hmichae2/combined-tirf-confocal-microscope/README.md

# combined-tirf-confocal-microscope

In this repository we show you how to build a setup for combined tirf and confocal microscopy. 

Here you see the page: https://hmichae2.github.io/combined-tirf-confocal-microscope/
