hmichae2/combined-tirf-confocal-microscope/images/slideshow/collimator.PNG

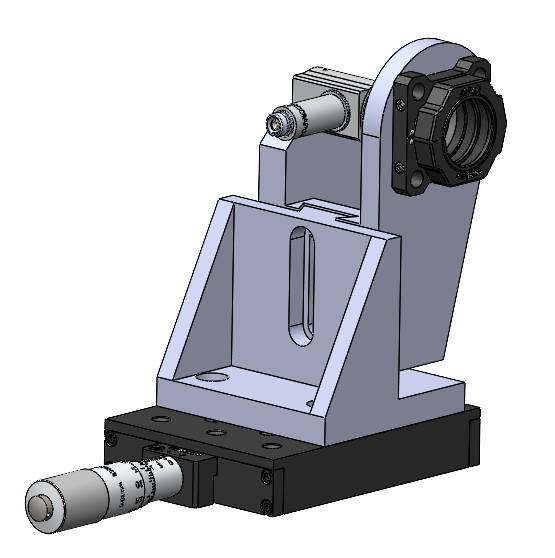
images/slideshow/collimator.PNG
