hmichae2/combined-tirf-confocal-microscope/images/slideshow/cube.PNG

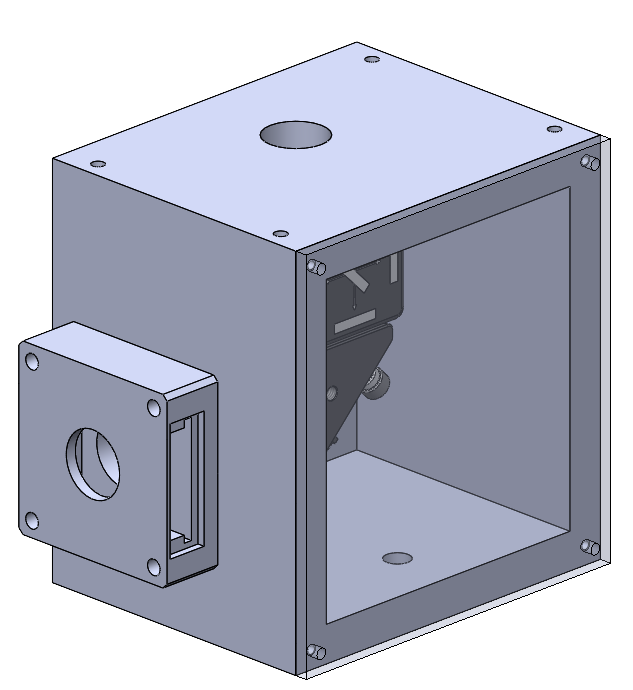
images/slideshow/cube.PNG
