hmichae2/combined-tirf-confocal-microscope/images/slideshow/sampleholder.PNG

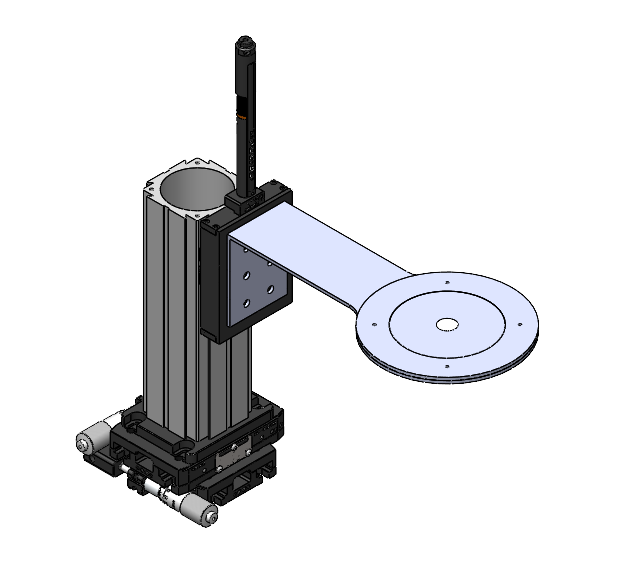
images/slideshow/sampleholder.PNG
