hmichae2/combined-tirf-confocal-microscope/images/components/camera_mount.PNG

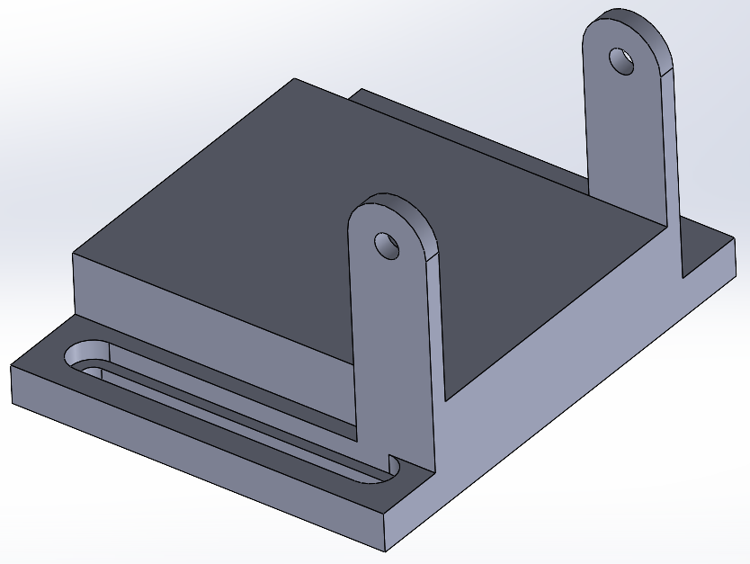
images/components/camera_mount.PNG
