hmichae2/combined-tirf-confocal-microscope/images/components/collimator_mount.PNG

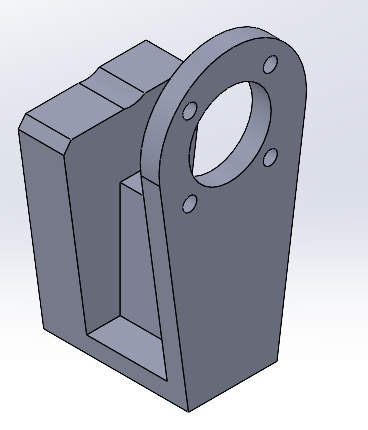
images/components/collimator_mount.PNG
