hmichae2/combined-tirf-confocal-microscope/images/components/collimator_mount_base.PNG

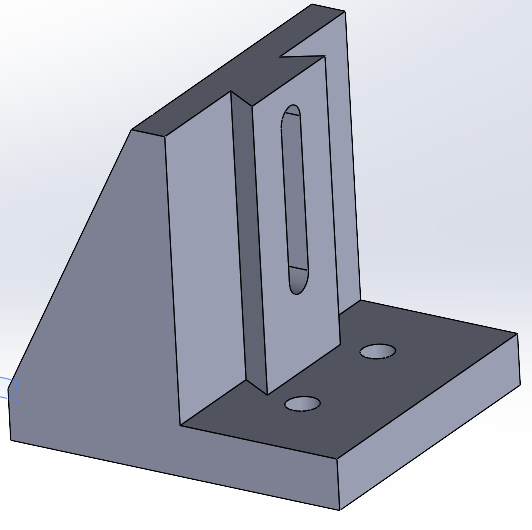
images/components/collimator_mount_base.PNG
