hmichae2/combined-tirf-confocal-microscope/images/components/cube.PNG

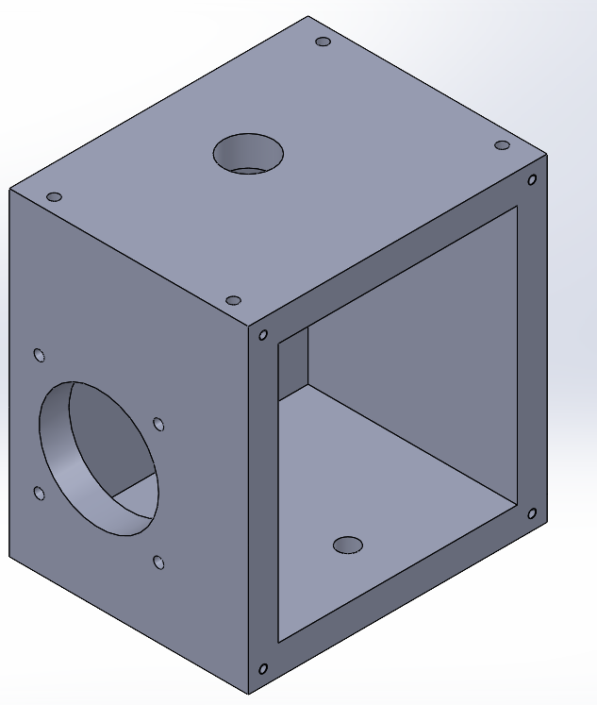
images/components/cube.PNG
