hmichae2/combined-tirf-confocal-microscope/images/components/laser_base_plate.PNG

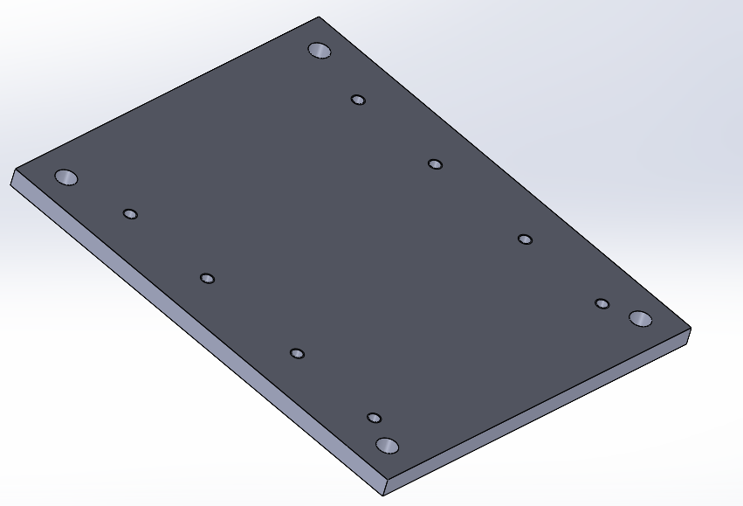
images/components/laser_base_plate.PNG
