hmichae2/combined-tirf-confocal-microscope/images/components/sample_holder.PNG

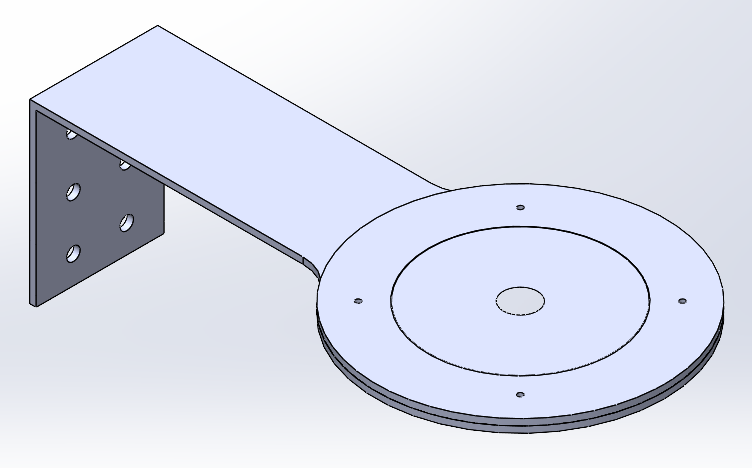
images/components/sample_holder.PNG
