hmichae2/combined-tirf-confocal-microscope/images/components/tube_lens_holder.PNG

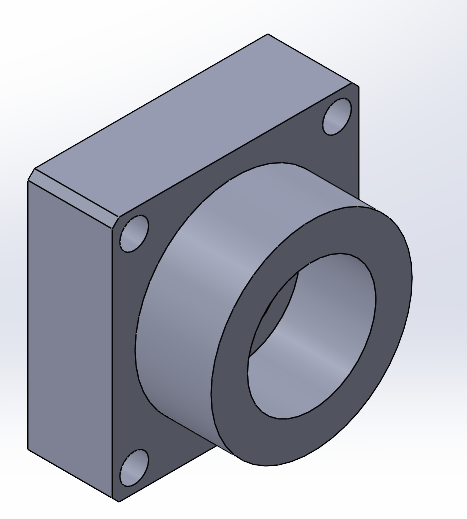
images/components/tube_lens_holder.PNG
