hmichae2/combined-tirf-confocal-microscope/components/cube door.STL

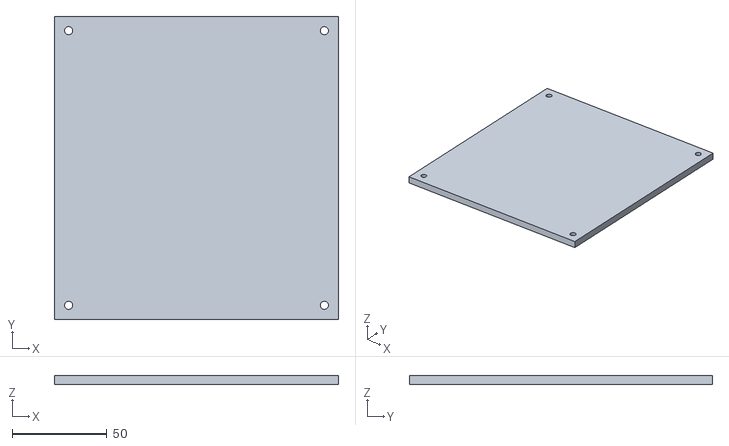
[picture p14: CAD file, 2021-05-02]
components/cube door.STL
150.0 x 160.0 x 5.00
