hmichae2/combined-tirf-confocal-microscope/components/sampleholder/sampleholder inlay.STL

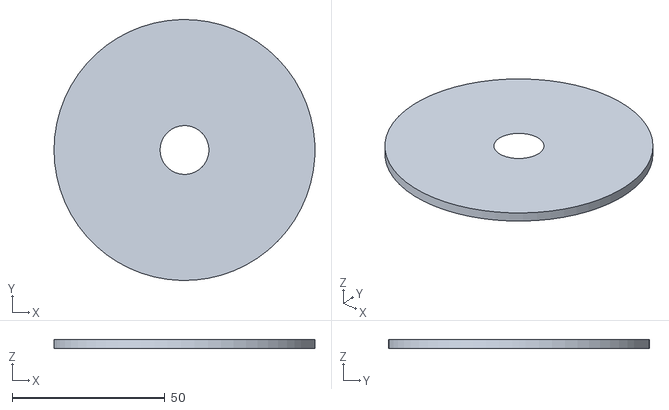
[picture p15: CAD file, 2021-05-02]
components/sampleholder/sampleholder inlay.STL
85.5 x 85.5 x 3.00
