hmichae2/combined-tirf-confocal-microscope/components/cube.STL

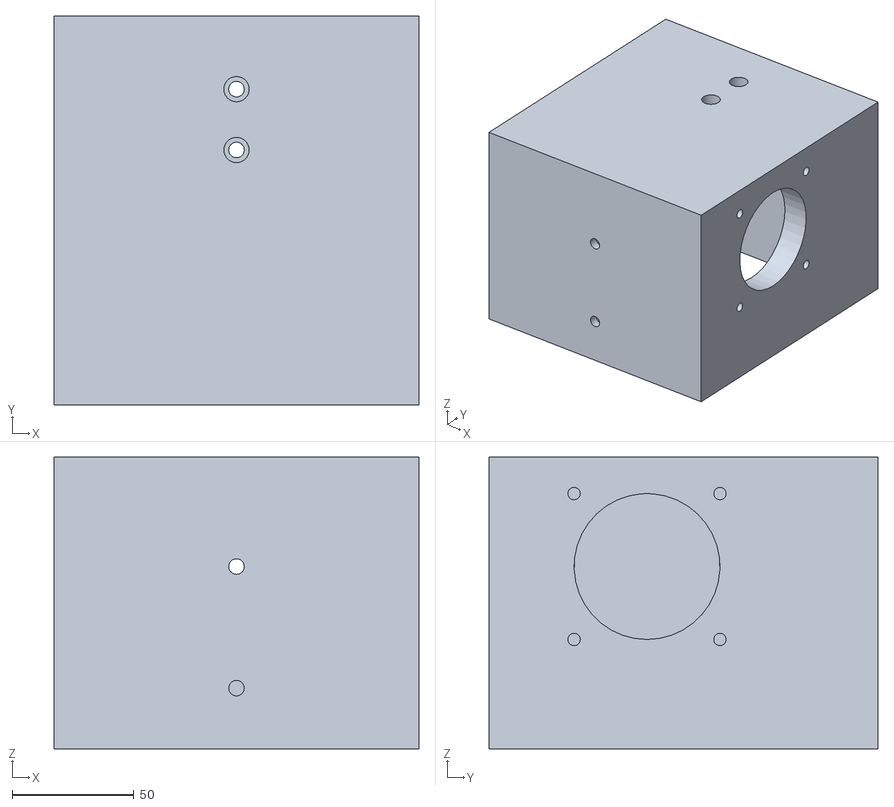
[picture p16: CAD file, 2021-05-02]
components/cube.STL
150.0 x 160.0 x 120.0
