hmichae2/combined-tirf-confocal-microscope/components/sampleholder/sampleholder.STL

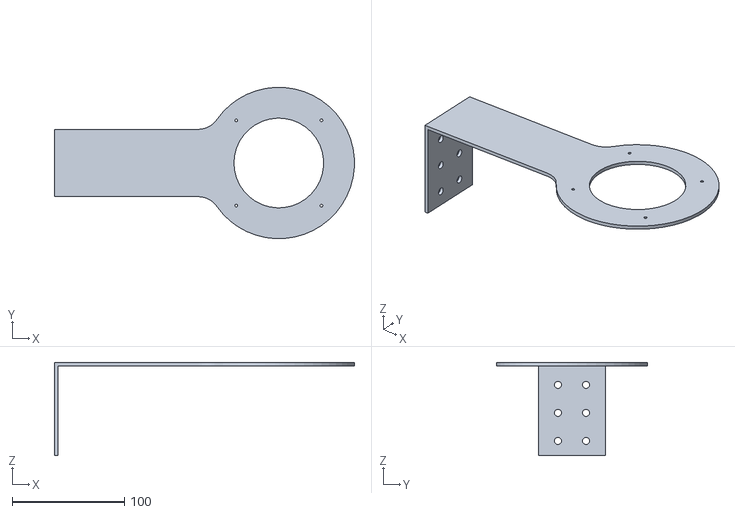
[picture p17: CAD file, 2021-05-02]
components/sampleholder/sampleholder.STL
267.5 x 135.0 x 83.0
