hmichae2/combined-tirf-confocal-microscope/components/sampleholder/sampleholder top.STL

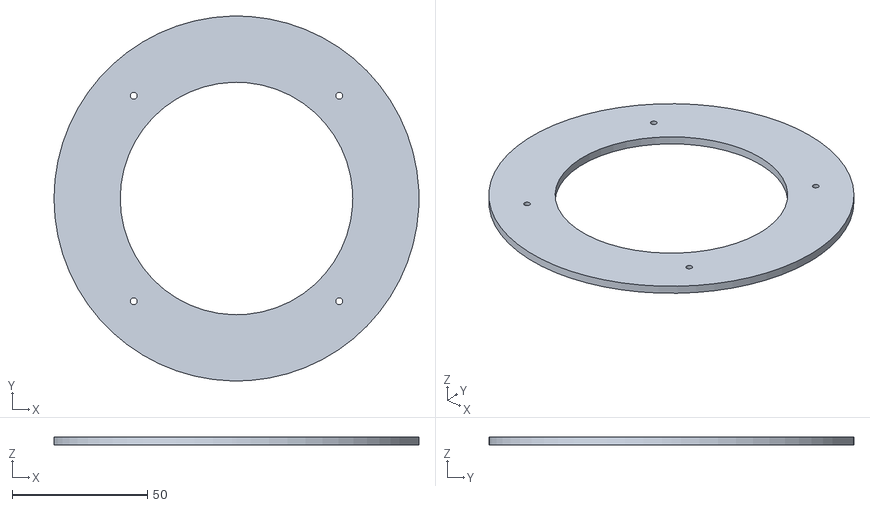
[picture p18: CAD file, 2021-05-02]
components/sampleholder/sampleholder top.STL
135.0 x 135.0 x 3.00
