hmichae2/combined-tirf-confocal-microscope/components/tube lens holder.STL

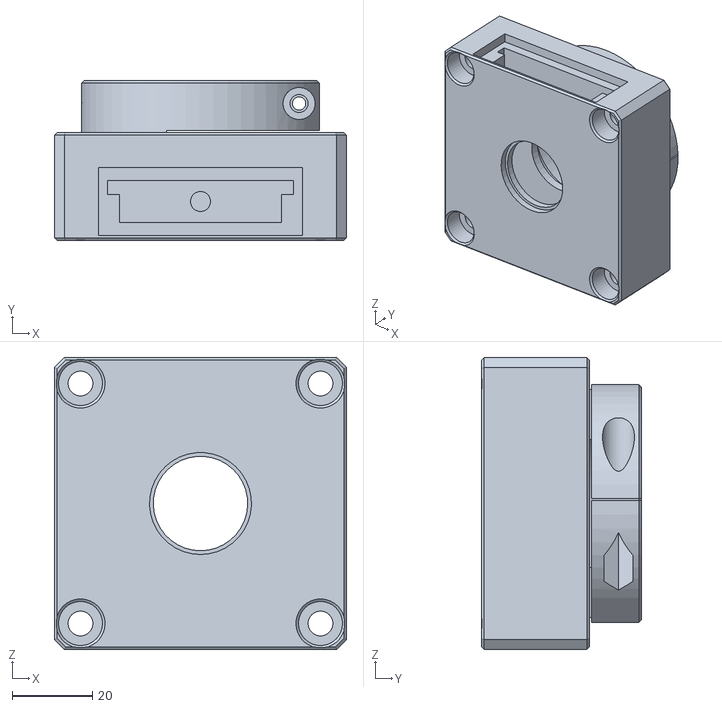
[picture p19: CAD file, 2021-05-02]
components/tube lens holder.STL
73.0 x 40.0 x 73.0
