hmichae2/combined-tirf-confocal-microscope/components/right angle mounting plate.STL

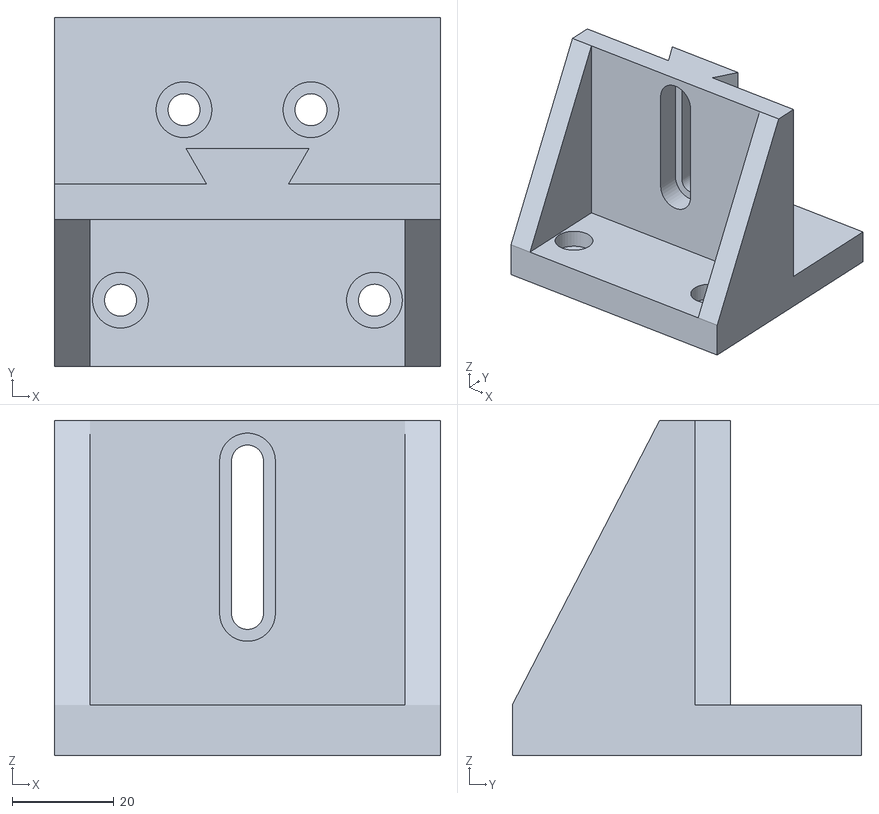
[picture p20: CAD file, 2021-05-02]
components/right angle mounting plate.STL
76.0 x 68.8 x 66.0
