hmichae2/combined-tirf-confocal-microscope/components/camera mount.STL

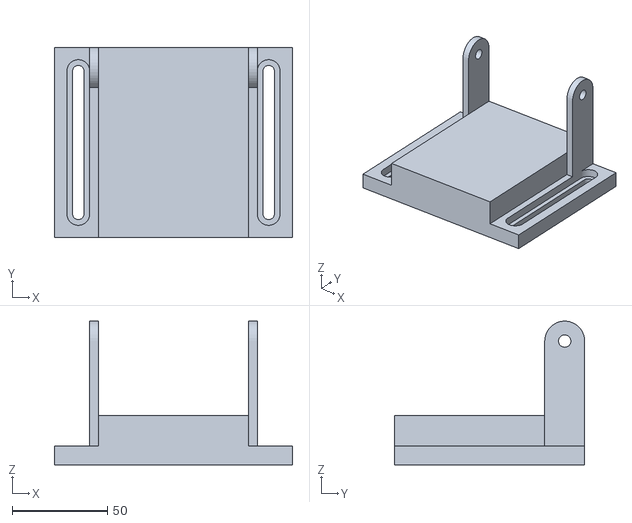
[picture p21: CAD file, 2021-05-02]
components/camera mount.STL
125.0 x 100.0 x 75.5
