hmichae2/combined-tirf-confocal-microscope/components/laser base plate.STL

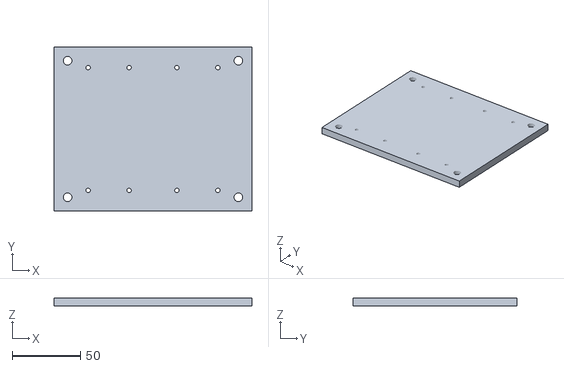
[picture p22: CAD file, 2021-05-02]
components/laser base plate.STL
145.0 x 120.0 x 6.00
