hmichae2/combined-tirf-confocal-microscope/components/reflective collimator holder.STL

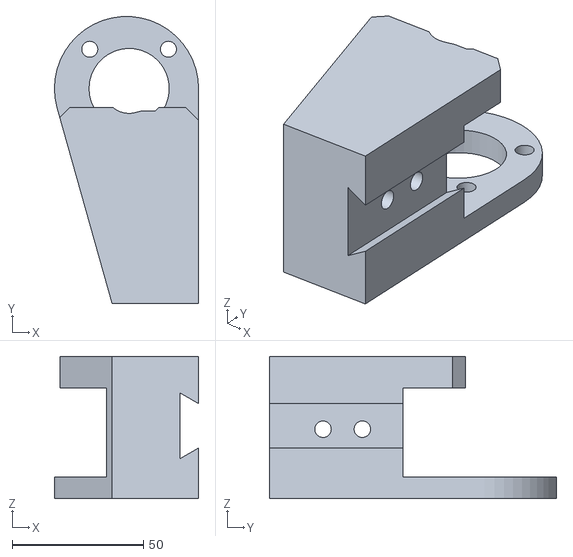
[picture p23: CAD file, 2021-05-02]
components/reflective collimator holder.STL
55.0 x 109.5 x 54.3
