hmichae2/combined-tirf-confocal-microscope/images/setup_confocal.png

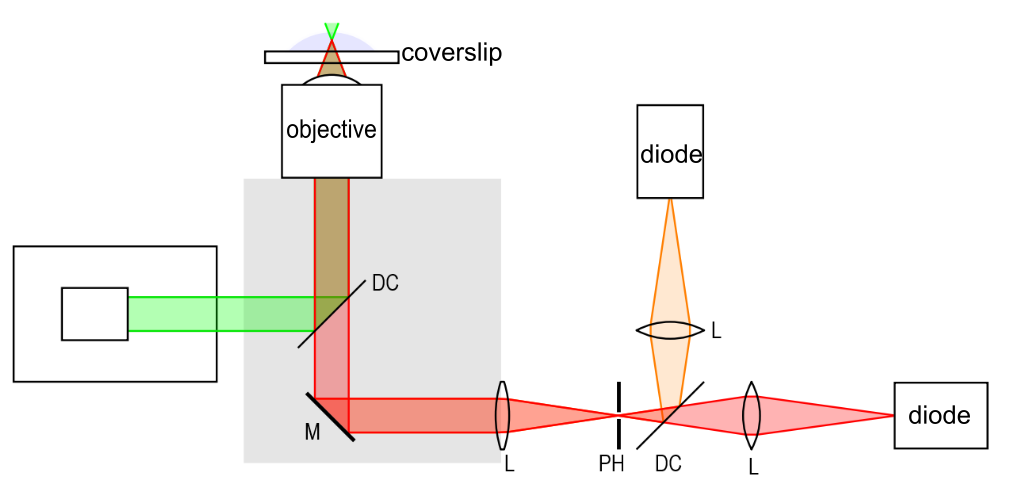
images/setup_confocal.png
