hmichae2/combined-tirf-confocal-microscope/images/setup_tirf.png

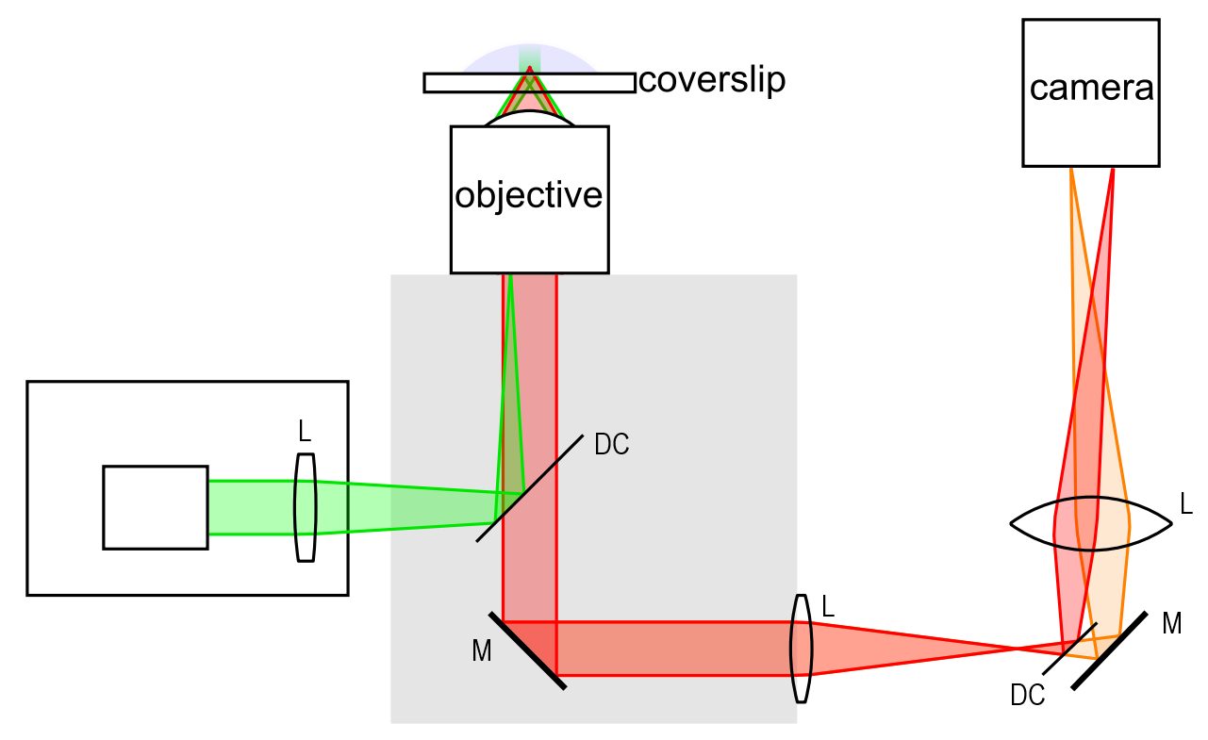
images/setup_tirf.png
